evbr2/dorito-finger-cleaner/README.md

This project was a bit. We wanted something simple but fun. This is motor with a brush attached that cleans your thumb and first 2 fingers.
