evbr2/dorito-finger-cleaner/docs/Wk7 Functional Decomposition.pdf

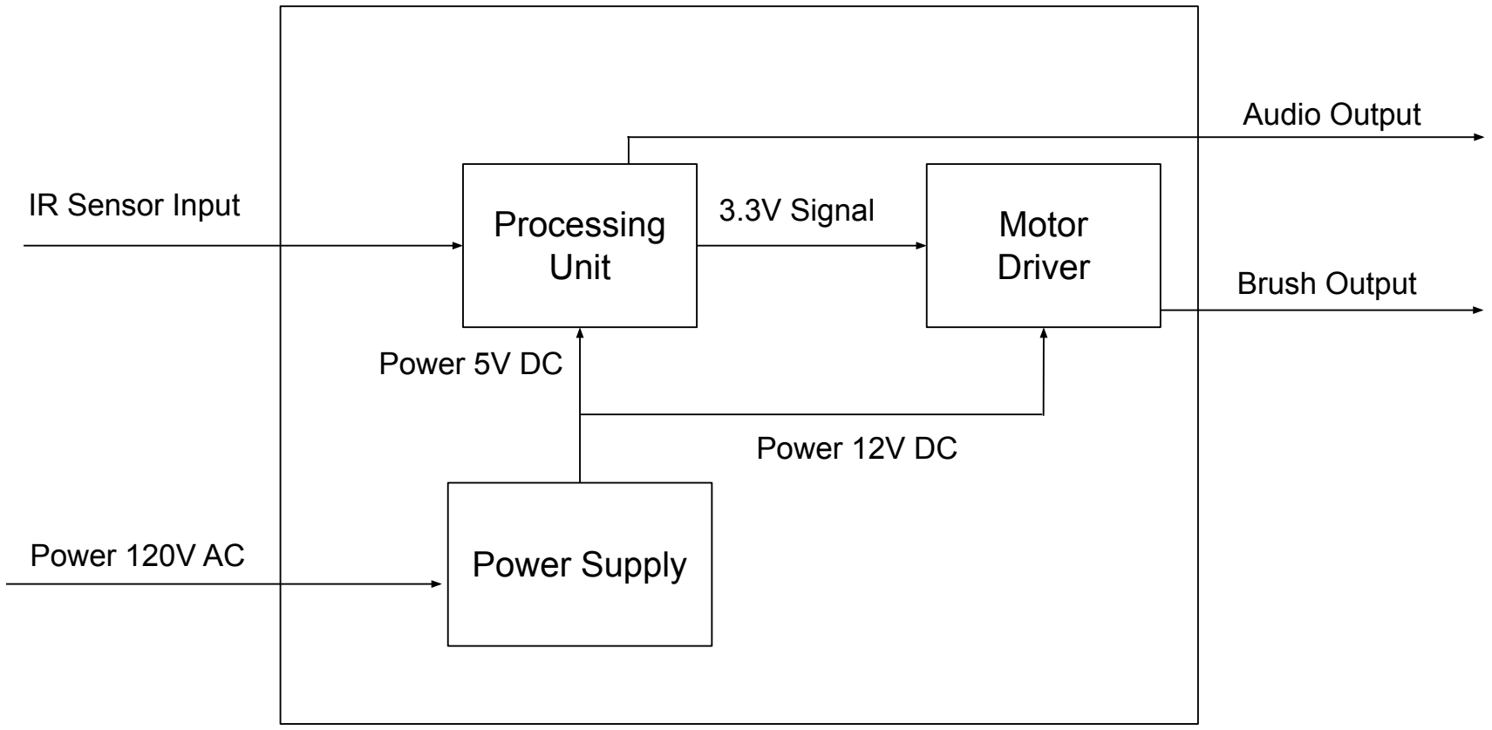
[picture p1: figure]
Motor Driver; Power Supply; IR Sensor Input; Audio Output; Brush Output; Power 12V DC; Processing Unit; Power 5V DC; 3.3V Signal; Power 120V AC

Dorito
Finger
Cleaner
Module | Dorito Finger Cleaner
Inputs | Power: 120V AC RMS, 60Hz IR Sensor: Emits IR and measures the reflected IR
Outputs | Audio Output: ?V Peak Motor: 12V DC, 0.6A, 150RPM
Functionality | When placing a hand into the device, the IR sensor will signal the motor and audio speaker to brush the hand and output sound.

Power 120V AC

IR Sensor Input

Motor Output

Audio Output

Level 0 | Level 1
