evbr2/dorito-finger-cleaner/board/Schematic_Finger_CLeaner_IC_Controller_2025-11-20.png

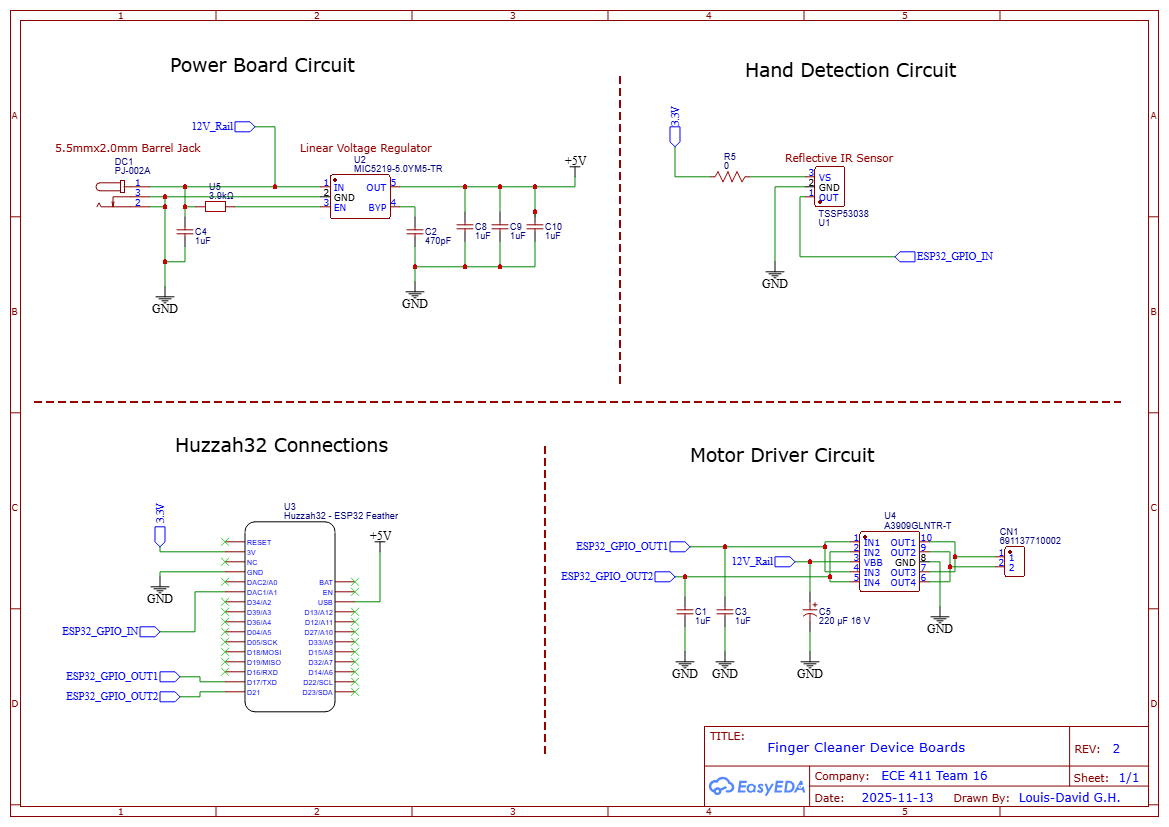
board/Schematic_Finger_CLeaner_IC_Controller_2025-11-20.png
