evbr2/dorito-finger-cleaner/docs/PCB_PCB_Finger_CLeaner_IC_Controller_3_2025-11-20.png

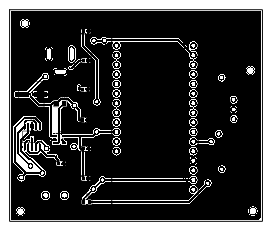
docs/PCB_PCB_Finger_CLeaner_IC_Controller_3_2025-11-20.png
