evbr2/dorito-finger-cleaner/docs/ECE411_Team16_BOM.xlsx - Sheet1.pdf

Index | Manufacturer Part Number Description | | Quantity | Unit Price | Total Price
1 | 3951 | HUZZAH32 ESP32 FEATHER MALE HDR 1 | | $20.95 | $20.95
2 | PDV-P8103 | CDS PHOTORESISTOR 16-33KOHM1 | | $0.70 | $0.70
3 | MIC5219-5.0YM5-TR IC REG LINEAR 5V 500MA SOT23-51 | | | $1.19 | $1.19
4 | PJ-002A | CONN PWR JACK 2X5.5MM SOLDER 1 | | $0.44 | $0.44
5 | FIT0492-A | GEARMOTOR 50 RPM 12V METAL1 | | $11.90 | $11.90
6 | A3909GLNTR-T | IC FULL BRIDGE DRIVER 1A 10-SOP1 | | $0.90 | $0.90
7 | CL10C471JB8NNNCCAP CER 470PF 50V C0G/NP0 06031 | | | $0.04 | $0.04
8 | CL10B105KO8NNNCCAP CER 1UF 16V X7R 0603 | | 6 | $0.01 | $0.04
9 | CRCW08053K90FKEAC RS 3.9K OHM 1% 1/8W 0805 1 | | | $0.04 | $0.04
| | | | Total: | $36.21
