evbr2/dorito-finger-cleaner/docs/ECE411_Team16_BOM.xlsx

PCB VERSION : 2
BOM VERSION: 2
Index | Manufacturer Part Number | Manufacturer Name | Description | Requested Quantity 1 | Pack Quantity 1 | Pack Type 1 | Digi-Key Part Number 1 | Unit Price 1 | Extended Price 1 | Minimum Order Quantity 1 | Datasheet | Reference Designator | US Import Tariff | Note | Part Status | Original Part numbers
1 | TSSP53038 | Vishay Semiconductor Opto Division | SENSOR OPT 940NM IR RADIAL 3 | 10 | 10 | Bulk | 751-TSSP53038-ND | 0.70300 | $7.03 | 1 | https://www.vishay.com/docs/82780/tssp530.pdf |  | N/A |  | Active | 751-TSSP53038-ND
2 | MIC5219-5.0YM5-TR | Microchip Technology | IC REG LINEAR 5V 500MA SOT23-5 | 6 | 6 | Cut Tape (CT) | 576-2770-1-ND | 1.19000 | $7.14 | 1 | https://ww1.microchip.com/downloads/aemDocuments/documents/OTH/ProductDocuments/DataSheets/MIC5219-500mA-Peak-Output-LDO-Regulator-DS20006021A.pdf |  | N/A |  | Active | 576-2770-2-ND
3 | J104D2C5VDC.15S | CIT Relay and Switch | RELAY GENERAL PURPOSE DPDT 2A 5V | 6 | 6 | Tube | 2449-J104D2C5VDC.15S-ND | 1.30000 | $7.80 | 1 | https://www.citrelay.com/wp-content/uploads/2025/05/Relay-J104D.pdf |  | May apply on shipments to the U.S. |  | Active | 2449-J104D2C5VDC.15S-ND
4 | MMBT3904-TP | MCC (Micro Commercial Components) | TRANS NPN 40V 0.2A SOT-23 | 10 | 10 | Cut Tape (CT) | MMBT3904TPMSCT-ND | 0.06300 | $0.63 | 1 | https://www.mccsemi.com/pdf/Products/MMBT3904(SOT-23).pdf |  | May apply on shipments to the U.S. |  | Active | MMBT3904TPMSTR-ND
5 | PJ-002A | Same Sky (Formerly CUI Devices) | CONN PWR JACK 2X5.5MM SOLDER | 10 | 10 | Bag | CP-002A-ND | 0.44200 | $4.42 | 1 | https://www.sameskydevices.com/product/resource/pj-002a.pdf |  | May apply on shipments to the U.S. |  | Active | CP-002A-ND
6 | FIT0492-B | DFRobot | GEARMOTOR 100 RPM 12V METAL | 5 | 5 | Bulk | 1738-1271-ND | 11.90000 | $59.50 | 1 | https://mm.digikey.com/Volume0/opasdata/d220001/medias/docus/7153/FIT0492-B.pdf |  | May apply on shipments to the U.S. |  | Active | 1738-1271-ND
7 | A3909GLNTR-T | Allegro MicroSystems | IC FULL BRIDGE DRIVER 1A 10-SOP | 10 | 10 | Cut Tape (CT) | 620-1498-1-ND | 0.90200 | $9.02 | 1 | https://www.allegromicro.com/~/media/Files/Datasheets/A3909-Datasheet.ashx |  | N/A |  | Active | 620-1498-2-ND
8 | CL10C471JB8NNNC | Samsung Electro-Mechanics | CAP CER 470PF 50V C0G/NP0 0603 | 10 | 10 | Cut Tape (CT) | 1276-1168-1-ND | 0.04100 | $0.41 | 1 | https://weblib.samsungsem.com/mlcc/mlcc-ec-data-sheet.do?partNumber=CL05Y105KP6VPN |  | N/A |  | Active | 1276-1168-2-ND
9 | CL10B105KO8NNNC | Samsung Electro-Mechanics | CAP CER 1UF 16V X7R 0603 | 40 | 40 | Cut Tape (CT) | 1276-1019-1-ND | 0.00700 | $0.28 | 1 | https://weblib.samsungsem.com/mlcc/mlcc-ec-data-sheet.do?partNumber=CL10B105KO8NNN |  | May apply on shipments to the U.S. |  | Active | 1276-1019-2-ND
10 | CRCW08053K90FKEAC | Vishay Dale | RES 3.9K OHM 1% 1/8W 0805 | 10 | 10 | Cut Tape (CT) | 541-CRCW08053K90FKEACCT-ND | 0.04000 | $0.40 | 1 | https://www.vishay.com/docs/28773/crcwce3.pdf |  | May apply on shipments to the U.S. |  | Active | 541-CRCW08053K90FKEACTR-ND
 |  |  |  |  |  |  |  | Total: | $96.63
REVISION DATES
REV 2 11-13-2025
REV 1: 10-23-2025
