evbr2/dorito-finger-cleaner/(list of files, drawings)

Other design files:
board/SCH_Finger_CLeaner_IC_Controller_2025-11-20.json
SCH_Finger_CLeaner_IC_Controller_2025-11-20.json
