evbr2/dorito-finger-cleaner/(commit log)

2025-10-29 REV1.0 Board Schematic
    Includes basic componentry.
2025-11-06 Week 6 - Broadboard Prototype
    Since we don't have some of the parts we ordered yet, we designed a prototype displaying the basic functionality of our design.
    When a hand is detected, power is supplied to the motor driver (or in this example, a fan).
2025-11-18 Adding Board CAD Rugh Draft to Git Repo
2025-11-18 Adding BOM to Repo
    [ECE411_Team16_BOM.xlsx]
2025-11-19 Adding Updated Rev 2 Schematic
2025-11-20 Schematic, 3D render, and Board PDF Added
2025-11-20 Adding EasyEDA Source Project File
    [SCH_Finger_CLeaner_IC_Controller_2025-11-20.json]
2025-12-08 Trying To Read IR Sensor Metrics
    Bad news, though touted as analog, it is in facta digital sensor.
2025-12-09 Working IR detection
    Kinda janky but I didn't plan for 38kHz digital signalling
    [IR_Roughly_working.ino]
2025-12-12 Bill of Mats
    Bill of Materials with per unit prices
2025-12-12 Rename ECE 411 Board Final (1).pdf to docs/ECE 411 Board Final (1).pdf
